floesche/Display-LED_G4_Hardware_Arena/development/arena_12-12/teensy4p1/teensy_arena_12-12_top_v0p3/assets/arena_top_12-12_front.png

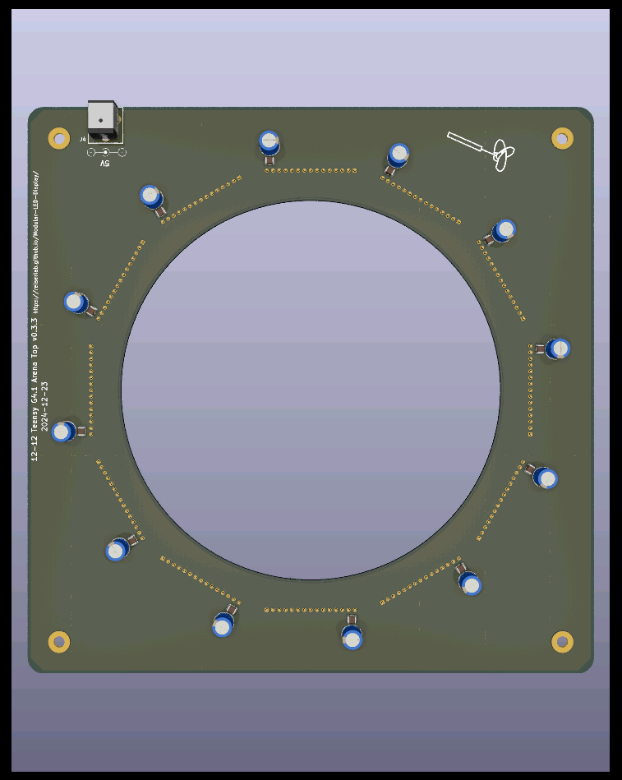
development/arena_12-12/teensy4p1/teensy_arena_12-12_top_v0p3/assets/arena_top_12-12_front.png
