floesche/Display-LED_G4_Hardware_Arena/development/arena_12-12/teensy4p1/teensy_arena_12-12_v0p3/assets/kicad_3d_view.png

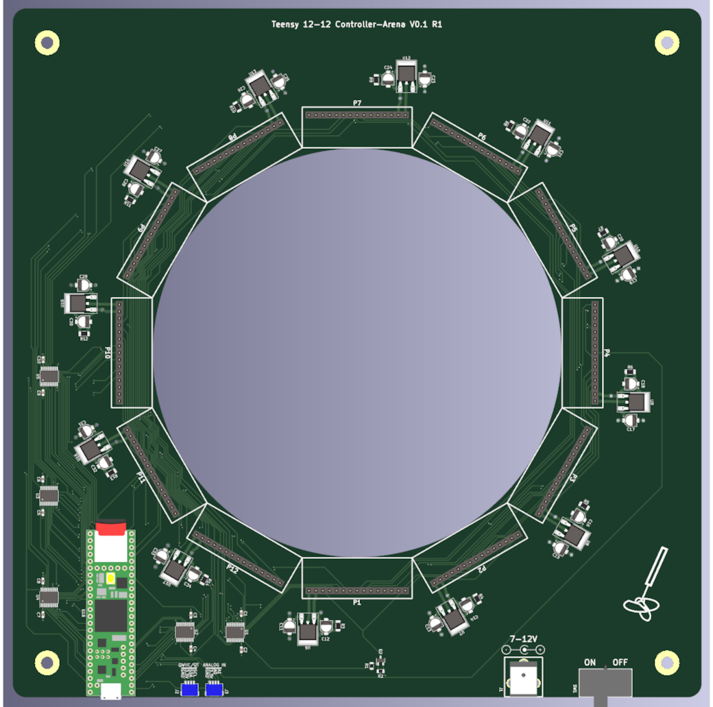
development/arena_12-12/teensy4p1/teensy_arena_12-12_v0p3/assets/kicad_3d_view.png
