floesche/Display-LED_G4_Hardware_Arena/development/arena_12-12_w_vreg/teensy4p1/teensy_arena_12-12_v0p2/production/version_0p2_r1/BOM_JLCPCB_teensy_arena_12-12_v0p2_r1.xlsx

Comment | Designator | Footprint | LCSC Part #（optional） | Qty
0.1uF ceramic Capacitor | C1, C2, C3, C4, C5, C6, C7, C8, C9, C10 | 0603 | C1591 | 10
10uF Ceramic Capacitor, 25V | C11, C14, C17, C20, C23, C26, C29, C32, C35, C38, C41, C44 | 0603 | C96446 | 12
100nF Ceramic Capacitor | C12, C15, C18, C21, C24, C27, C30, C33, C36, C39, C42, C45 | 0603 | C1591 | 12
22uF Ceramic Capacitor | C13, C16, C19, C22, C25, C28, C31, C34, C37, C40, C43, C46 | 0603 | C2762594 | 12
3.3uH Inductor | L1, L2, L3, L4, L5, L6, L7, L8, L9, L10, L11, L12 | SMD,7.2x6.6mm | C5189747 | 12
200 Ohm resistor | R1 | 0805 | C17540 | 1
20k Ohms resistor | R2 | 0805 | C4328 | 1
56.2k Resistor, 0.1% | R3, R5, R7, R9, R11, R13, R15, R17, R19, R21, R23, R25 | 0603 | C705784 | 12
10k Resistor, 0.1% | R4, R6, R8, R10, R12, R14, R16, R18, R20, R22, R24, R26 | 0603 | C95204 | 12
MOSFET N-channel | Q2 | SOT-23 | C165220 | 1
Level shifter TXB0108PWR | U1,U2,U3,U4,U5 | TSSOP-20 | C53406 | 5
TPS564201DDC Step-Down Regulator | U6, U7, U8, U9, U10, U11, U12, U13, U14, U15, U16, U17 | TSOT-23-6 | C464812 | 12
4-Pin Connector, JST SM04B-SRSS-TB or similar | J2 ,J3 | SMD,P=1mm | C145956 | 2
DC Power Barrel Jack | J1 | through hole | global parts | 1
15x1 female header, 0.1in pitch | P1,P2,P3,P4,P5,P6,P7,P8,P9,P10,P11,P12 | through hole | global parts | 12
Slide Switch SPDT | SW1 | through hole | global parts | 1
Teensy4.1 | U18 | through hole | global parts | 1
