floesche/Display-LED_G4_Hardware_Arena/development/arena_12-12/teensy4p1/teensy_arena_12-12_top_v0p3/production/version_0p1_r1/BOM_JLCPCB_arena_top_12-12_v0p1_r1.xlsx

Comment | Designator | Footprint | LCSC Part | Qty
100uF ceramic Capacitor | C3,C4,C12,C8,C5,C11,C1,C2,C6,C10,C9,C7 | 1210 | C7432790 | 12
100uF Electrolytic Capacitor | C16,C24,C23,C19,C21,C22,C14,C18,C17,C20,C15,C13 | CP_Radial_D8.0mm_P2.50mm | global parts | 12
DC Power Barrel Jack | J1 | through hole | global parts | 1
15x1 male header, 0.1in pitch | P1,P2,P3,P4,P5,P6,P7,P8,P9,P10,P11,P12 | through hole | global parts | 12
