floesche/Display-LED_G4_Hardware_Arena/development/arena_12-12/teensy4p1/teensy_arena_12-12_top_v0p3/production/version_0p1_r1/nonlscs_bom_arena_top_12-12_v0p1_r1.xlsx

Global arts for JLPCB assembly
Comment | Designator | Footprint | Qty | Digikey PN
DC Power Barrel Jack | J1 | through hole | 1 | CP-063AH-ND
15x1 male header, 0.1in pitch | P1,P2,P3,P4,P5,P6,P7,P8,P9,P10,P11,P12 | through hole | 12 | S1011EC-40-ND
100uF Electrolytic Capacitor | C16,C24,C23,C19,C21,C22,C14,C18,C17,C20,C15,C13 | CP_Radial_D8.0mm_P2.50mm | 12 | 1189-1856-ND
