floesche/Display-LED_G4_Hardware_Arena/(list of files, drawings)

Other design files:
development/arena_12-12/teensy4p1/teensy_arena_12-12_v0p1/teensy_arena_12-12.dsn
development/arena_12-12/teensy4p1/teensy_arena_12-12_v0p3/teensy_arena_12-12.dsn
development/arena_12-12/top/arena_top_12-12/arena_top_12-12.dsn
