floesche/Display-LED_G4_Hardware_Arena/(commit log)

2024-12-23 rename to prepare merge with IORodeo
    [BOM.xls, BOM_JLCPCB_teensy_arena_12-12_v0p1_r1.xlsx, holes.kicad_sch, level_shifters.kicad_sch, modified_teensy_arena_12-12.kicad_pcb, nonlscs_bom_teensy_arena_12-12_v0p1_r1.xlsx, panel_headers.kicad_sch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]
2024-12-23 pull development directory from IORodeo
    [BOM_JLCPCB_teensy_arena_12-12_v0p1_r1.xlsx, holes.kicad_sch, level_shifters.kicad_sch, modified_teensy_arena_12-12.kicad_pcb, nonlscs_bom_teensy_arena_12-12_v0p1_r1.xlsx, panel_headers.kicad_sch, power.kicad_sch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]
2024-12-23 add top arena
    [BOM.xls, BOM_JLCPCB_arena_top_12-12_v0p1_r1.xlsx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]
2024-12-23 bump buffer version to 0.2
    [BOM.xls, BOM_JLCPCB_teensy_arena_12-12_v0p1_r1.xlsx, holes.kicad_sch, level_shifters.kicad_sch, modified_teensy_arena_12-12.kicad_pcb, nonlscs_bom_teensy_arena_12-12_v0p1_r1.xlsx, panel_headers.kicad_sch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]
2024-12-23 first step cleanup
    [holes.kicad_sch, level_shifters.kicad_sch, panel_headers.kicad_sch, power.kicad_sch, teensy.kicad_sch, teensy_arena_12-12.kicad_pcb, teensy_arena_12-12.kicad_sch, teensy_arena_12-12_copy.kicad_pcb]
2024-12-23 bump version to 0.3
    [BOM_JLCPCB_teensy_arena_12-12_v0p1_r1.xlsx, holes.kicad_sch, level_shifters.kicad_sch, modified_teensy_arena_12-12.kicad_pcb, nonlscs_bom_teensy_arena_12-12_v0p1_r1.xlsx, panel_headers.kicad_sch, power.kicad_sch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]
2024-12-23 export for production
    [arena_top_12-12.kicad_pcb, holes.kicad_sch, level_shifters.kicad_sch, panel_headers.kicad_sch, power.kicad_sch, teensy.kicad_sch]
2024-12-23 cleanup top
    [BOM.xls, BOM_JLCPCB_arena_top_12-12_v0p1_r1.xlsx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]
